acroscarrillo/FencingBox/pcb_files/readme.md

# About
This folder is dedicated to store the relevant fabrication files (Gerber, BOM...) for modifying/ordering
the PCB.
