acroscarrillo/FencingBox/(commit log)

2023-01-16 wiring diagram
2023-01-16 chip wiring
2023-01-16 added a blink.ino for the board to test all is good
2023-01-17 updated for new board
2023-01-17 added a interrupt + debounce minimal for atmega chip
2023-01-18 added firmware for board (buggy)
    [atmega328p_fencing_box.ino]
2025-05-13 added pcb picture
